KwonGit23/led-piano-guide/docs/Schematic.pdf

A | A

1

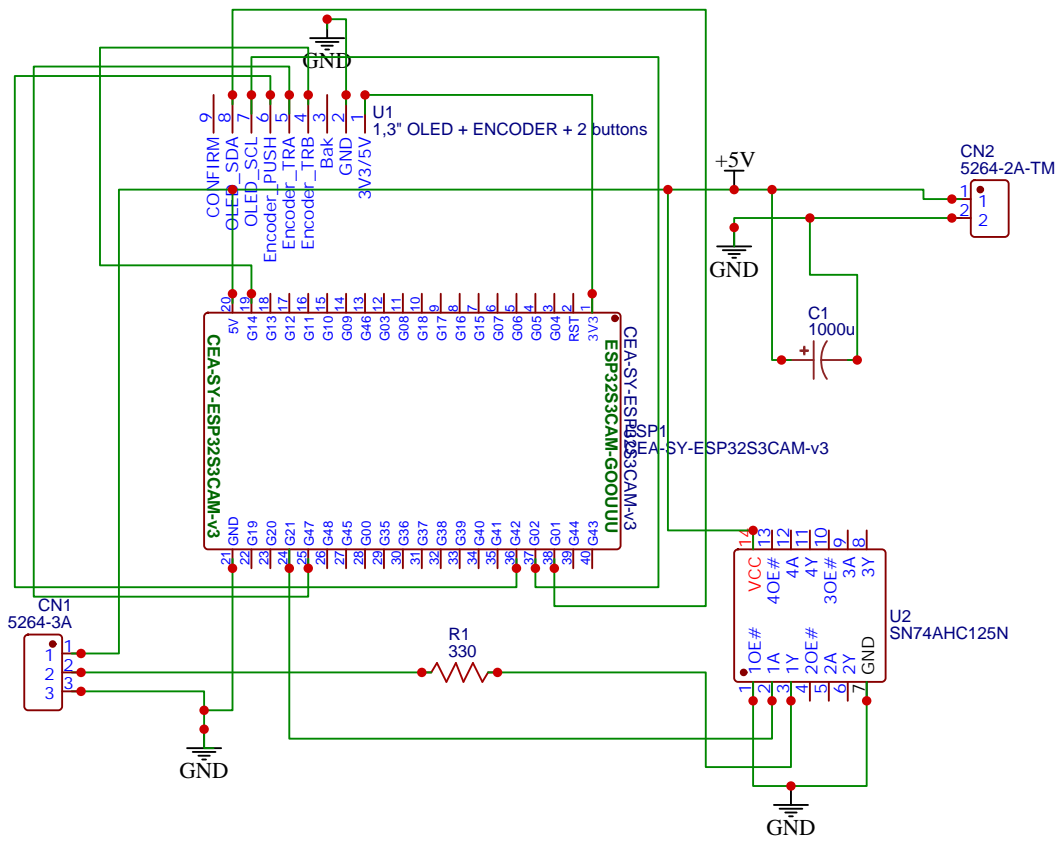
[picture p3: page 1]
