KwonGit23/led-piano-guide/(commit log)

2026-08-18 docs: README 수정
2026-08-18 docs: README.md 수정
